AndrejChoo/USBAsp_for_parallel_programming/hardware/images/Board_Down.jpg

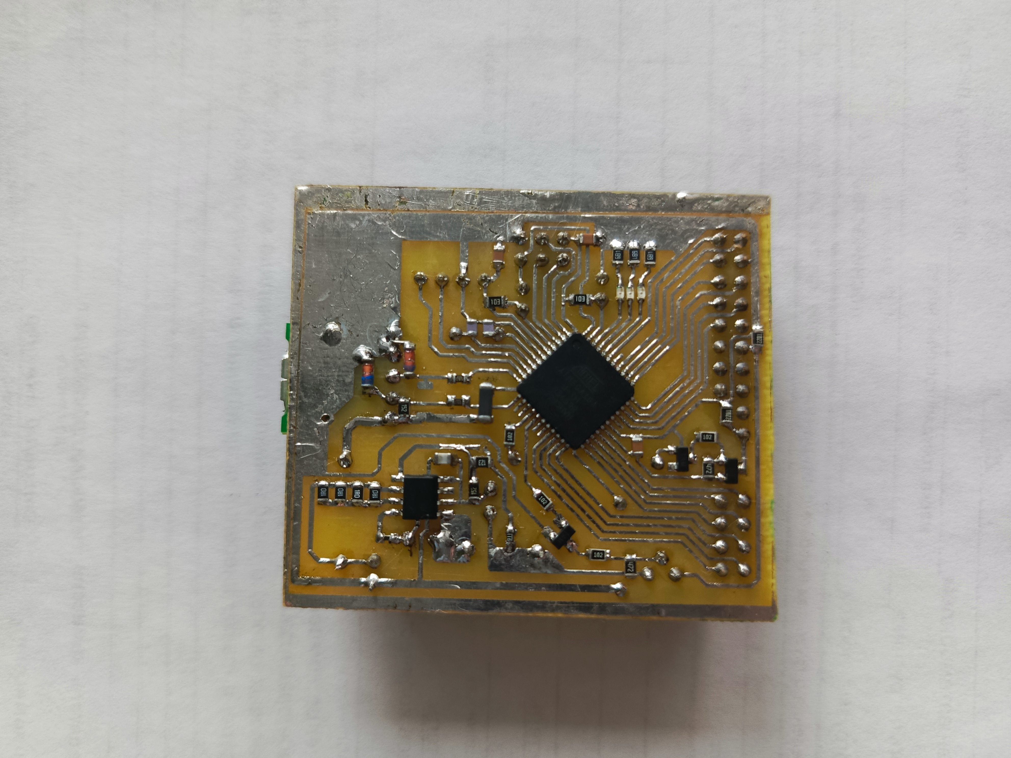
hardware/images/Board_Down.jpg
