AndrejChoo/USBAsp_for_parallel_programming/hardware/images/Board_Up.jpg

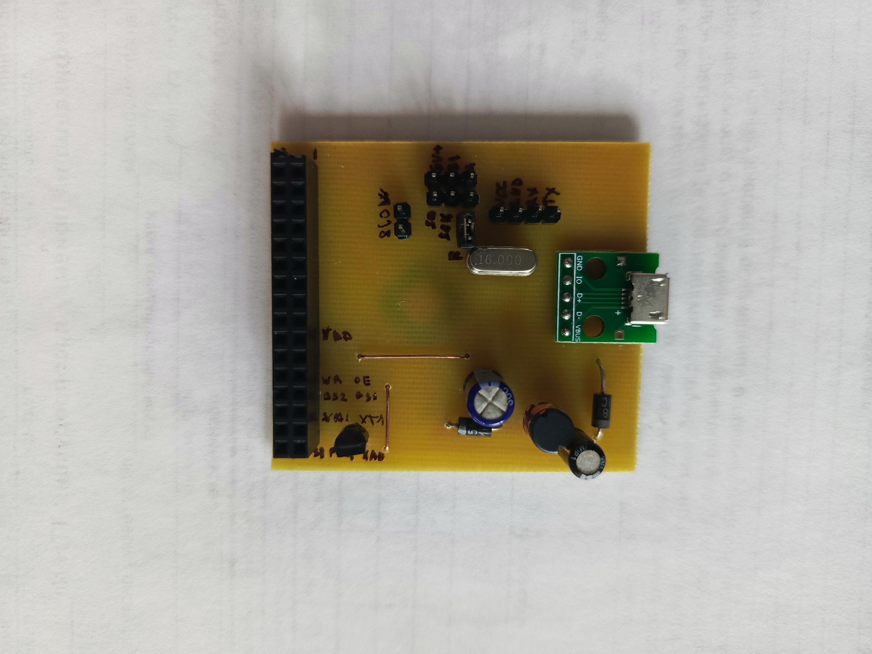
hardware/images/Board_Up.jpg
