AndrejChoo/USBAsp_for_parallel_programming/hardware/pcb/board.JPG

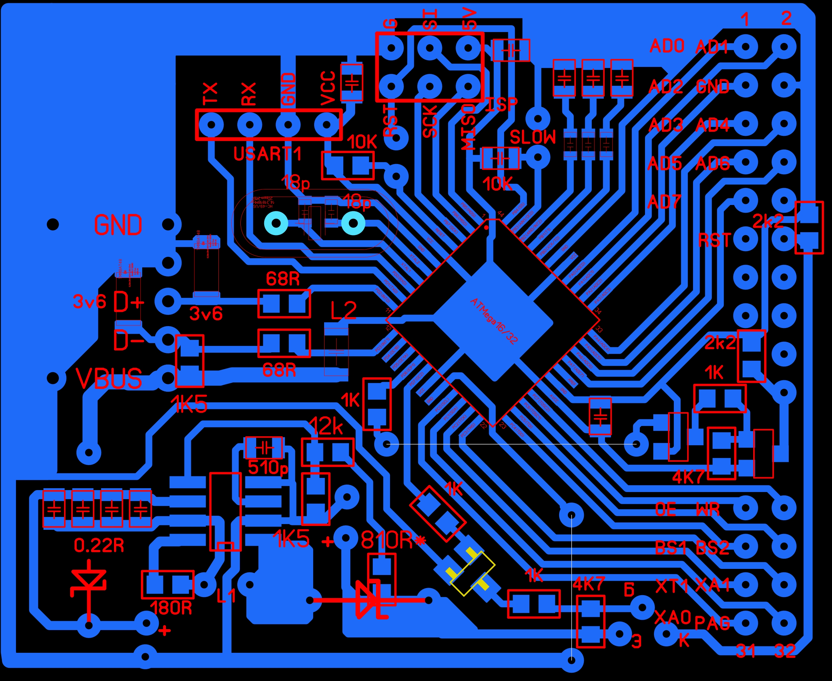
hardware/pcb/board.JPG
