AndrejChoo/USBAsp_for_parallel_programming/hardware/schemes/Schematic_USBAsp_parallel_2024-02-17.pdf

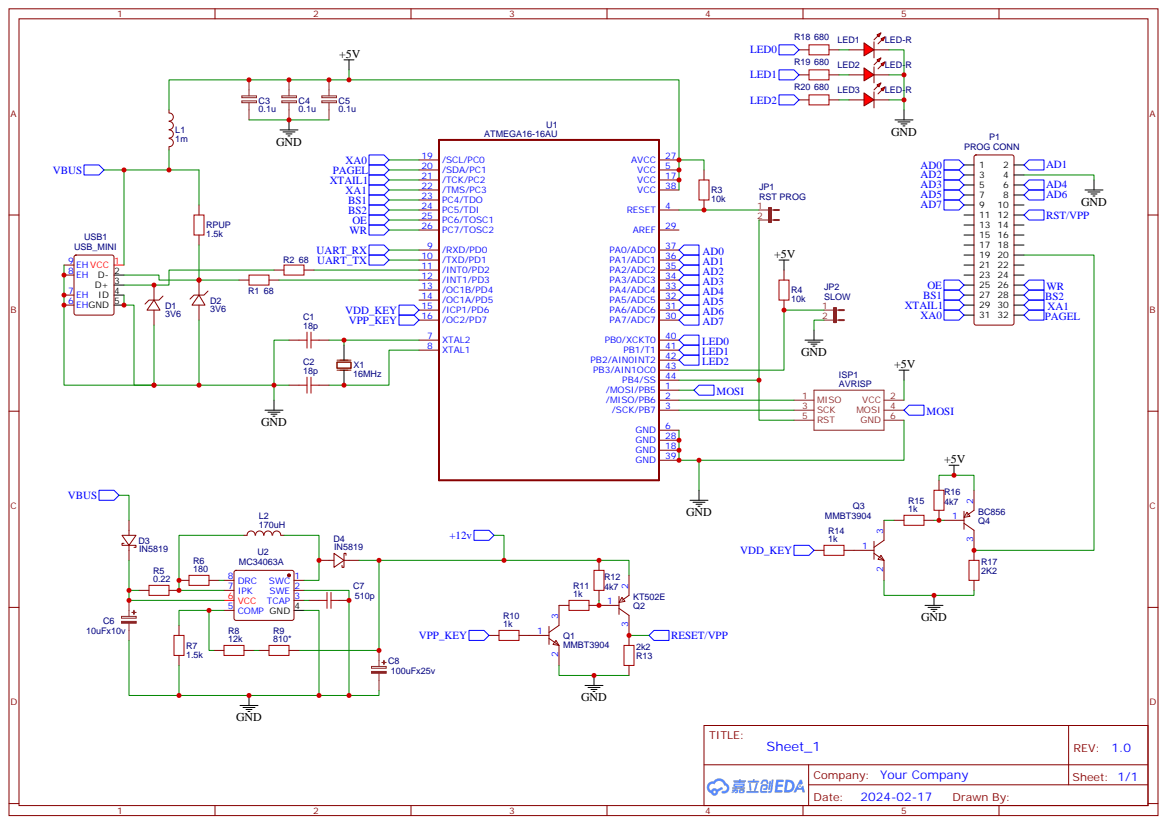
[picture p4: page 1]
