AndrejChoo/USBAsp_for_parallel_programming/hardware/schemes/Schematic_Adapters_USBAsp_p_2024-02-17.pdf

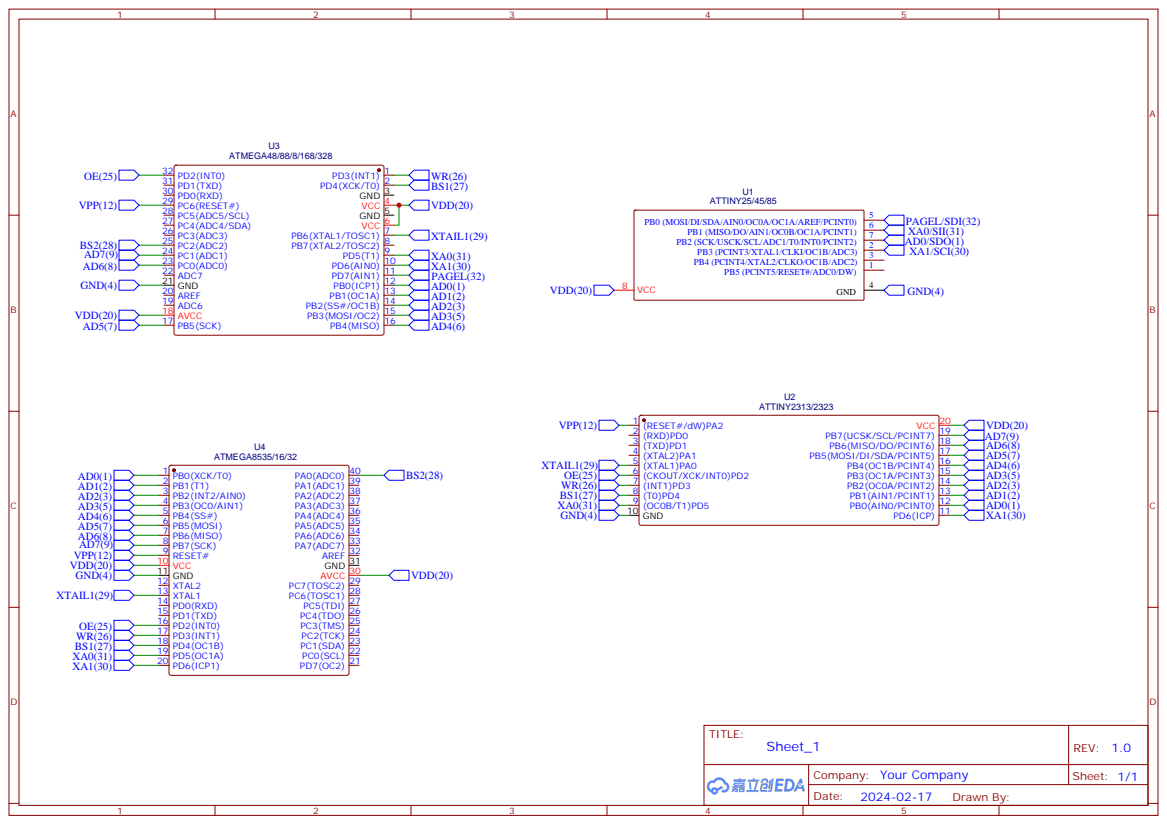
[picture p5: page 1]

PB0 (MOSI/DI/SDA/AIN0/OC0A/OC1A/AREF/PCINT0)
