AndrejChoo/USBAsp_for_parallel_programming/(list of files, drawings)

Other design files:
hardware/adapters/atmega8_168_328_adapter.lay6
hardware/adapters/atmega16_32_adapter.lay6
hardware/adapters/attiny2313_x5_adaptes.lay6
hardware/pcb/Parallel_USBAsp_tqfp44.lay6
